shortbloke/DogDoor/(threads)

Thread 3 (2020-01-10):

Publish sensor values when presence detected never happens in checkSensorChange

shortbloke, 2020-01-10:
As checkSensorChange is only called when desidredState != STATE_OPEN, calling checkSensorChange to log the sensor value when we've detected movement won't happen, as the act of detecting movement in the ISR will have set the desiredState to STATE_OPEN

shortbloke, 2020-01-10:
Fixed

Closed 2020-01-10.

Thread 6 (2020-01-17):

Watchdog required when currentState != desiredState

shortbloke, 2020-01-17:
DogDoor stopped opening today, even though desiredState=OPEN. Not sure why.

1) Examine code and determine when/why this could occur and fix it (if possible)
2) Add a watchdog timer to reset the device if it fails to reach the desired state within a fixed time interval.

The problem, when it occurred, was fixed by sending a remote reset command, so the device was still working through the main loop.

Thread 7 (2020-07-23):

Log

bsr203, 2020-07-23:
Hi.
I am new to Arduino, and learning from your project. I see usage of `Log` throughout the code, but don't see an import. Which library do you use? I am also looking for a good logger than outputting to serial.

Thanks.
bsr

shortbloke, 2020-07-23:
I'm using a Particle Photon for this project which provides the Log instance of the Logger class: https://docs.particle.io/reference/device-os/firmware/photon/#logging-levels

bsr203, 2020-07-23:
Thanks. While searching I found https://embeddedartistry.com/blog/2019/12/30/arduino-logging-library/
look very thought out. will give it a try. thanks again. Cheers

Closed 2020-07-23.

Thread 8 (2021-03-07):

Not working when WiFi unavailable or Particle cloud offline

shortbloke, 2021-03-07:
Observed that when the device is unable to connect to Particle Cloud for whatever reason, the device blocks trying to connect and the main loop doesn't run.

This appears to be due to a change in firmware, some time ago. Reviewing the current documentation indicates the approach currently used isn't correct.

Closed 2021-03-07.
