shortbloke/DogDoor/(commit log)

2020-01-01 Working implementation (#1)
    Initial working project.
    Optimised for keeping any many cycles available to run the stepper as fast as possible by minimising time reading I/O.
    Initial experimental support for some limited interaction via Particle.io Console.
    Partial documentation.
2020-01-02 Larger gear lacked torque to lift
2020-01-05 BugFix - Publishing on change only worked once. Sensor value rather than detection state was being stored in the last variable.
    [DogDoor.ino]
2020-01-06 Continue to try and reduce false triggering from internal sensor
2020-01-06 Remove extra delays impacting motor smoothness when sensors active
2020-01-07 Try and reset device if connection to cloud is lost and is unrecoverable. Don't do publishing to Cloud if door is expected to be moving - Loop performance.
    [DogDoor.ino]
2020-01-08 Stability and Performance fixes (#2)
    Use volatile variables for those shared with ISR.
    Avoid trying to log during ISR.
    Optimise main loop and stepper driving function to focus work on stepper.run() to move the stepper as fast as possible. 38% improvement from the original. Taking around 4 seconds to open the PetDoor from ~6.5 seconds.
    [DogDoor.ino]
2020-01-09 Ensure non-critical tasks run periodically. Not only when current state matches desired state.
2020-01-10 Add MQTT support (#5)
    * Add MQTT support
    * Add details of particle cloud and MQTT support
    * Ensure non-critical tasks run periodically.
    Not only when current state matches desired state.
    * Make set "retain" flag on MQTT messages (issue: #4)
    Fix Particle publish not being when sensor detects movement (issue #3)
    [DogDoor.ino]
2020-01-21 Robustness improvements. - Add a watchdog for when it takes too long to reach the desiredState. - Reduce sensitivity of indoor sensor further. - Add more logging to Particle Cloud when using mqtt - P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
    [DogDoor.ino]
2020-01-21 Correct typo in Cloud variable name
    [DogDoor.ino]
2020-04-13 Map doorStates to mqtt states. To uses expected values for mqtt cover sensor
2020-06-01 Fix keepOpenTimer watchdog from triggering when using overrideDoorState
    [DogDoor.ino]
2020-07-16 Fix lookup of overriden desired state for Particle console
    [DogDoor.ino]
2021-03-07 Fixes #8 - Refactor how Particle Cloud is used
    [DogDoor.ino]
2021-03-27 Re-enable MQTT publishing Still ignore SET commands as triggered on MQTT broker connection, causing door to open. Rate limit MQTT connection attempts.
    [DogDoor.ino]
2021-08-08 Add publishManager library to avoid hitting rate limiting and message caching when publishing to Particle.io cloud
    [DogDoor.ino]
